minodori/spider_robot/modeling/sg90_arm.png

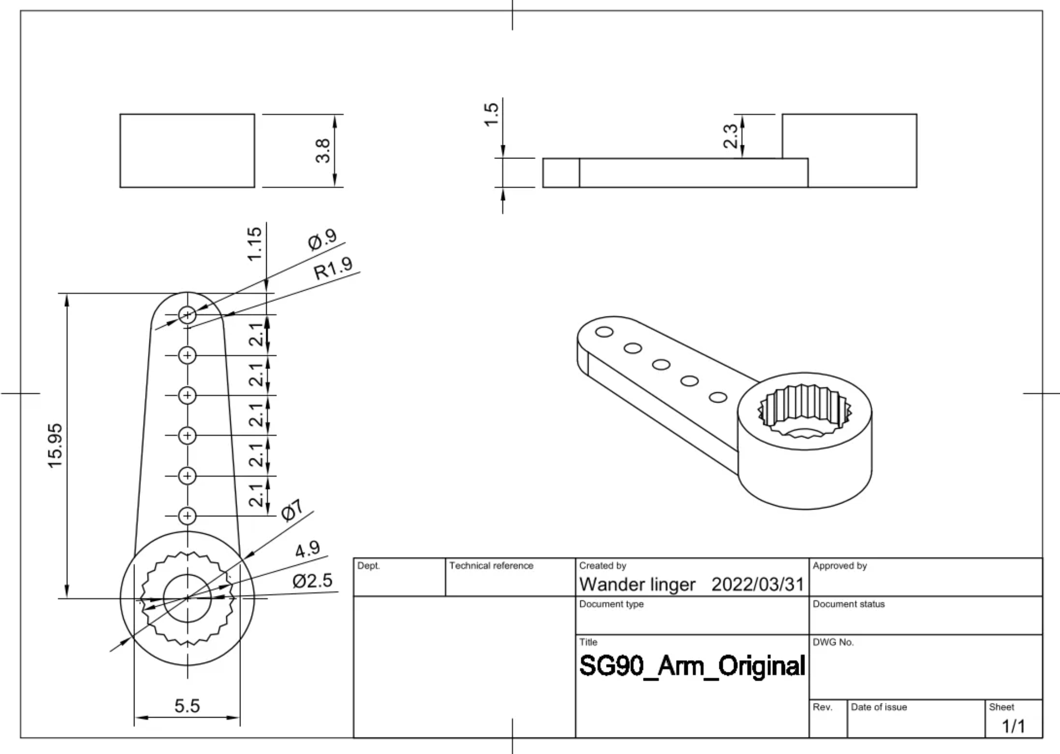
modeling/sg90_arm.png
