minodori/spider_robot/modeling/sg_90.png

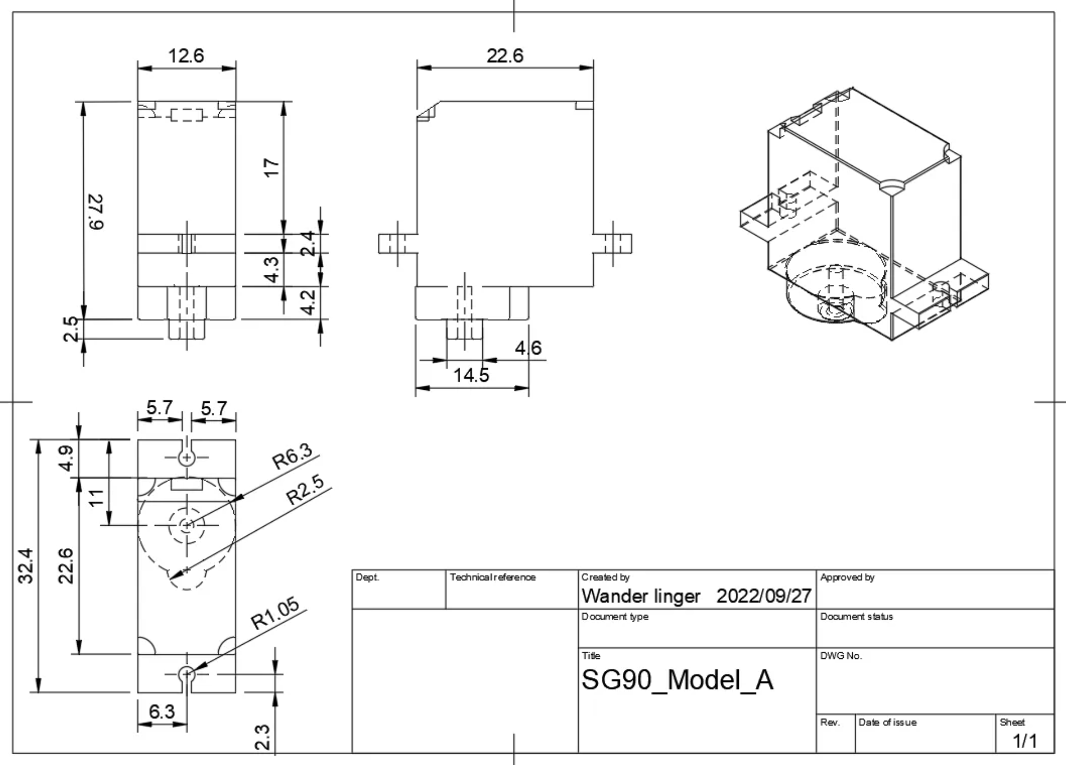
modeling/sg_90.png
