minodori/spider_robot/modeling/PlateTop_esp32_pcbway.3mf

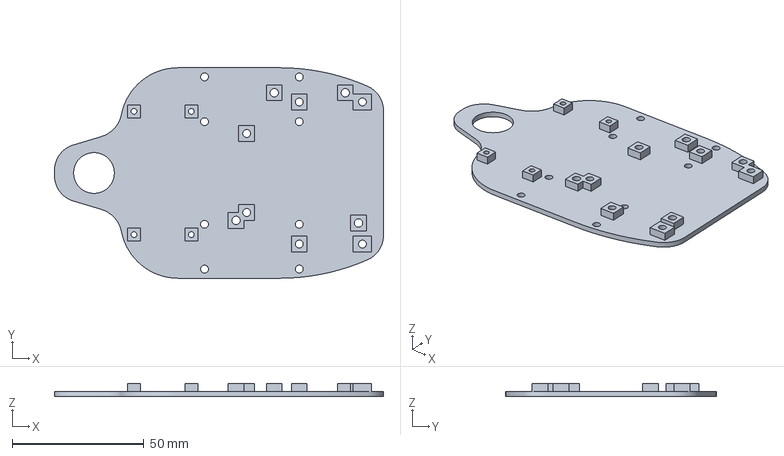
[picture p3: CAD file, 2026-04-04]
modeling/PlateTop_esp32_pcbway.3mf
125.0 x 80.0 x 5.00 mm
