minodori/spider_robot/modeling/PlateTop_esp32_pcbway_xl4015.3mf

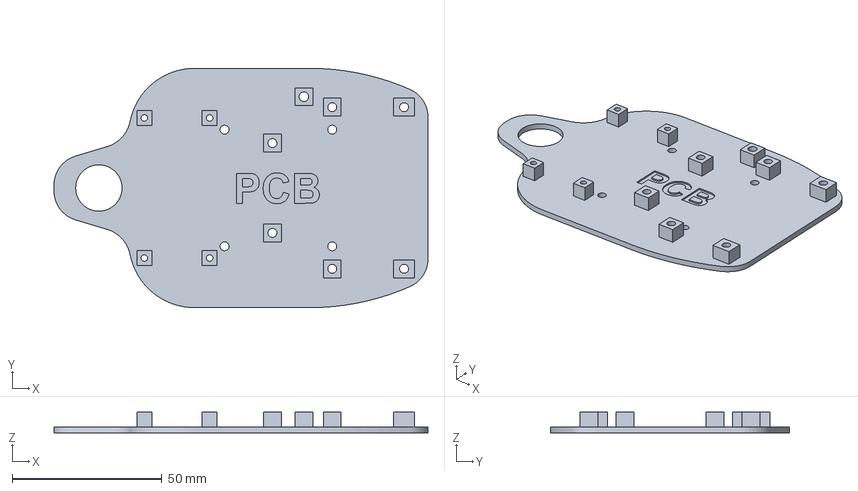
[picture p4: CAD file, 2026-04-04]
modeling/PlateTop_esp32_pcbway_xl4015.3mf
125.0 x 80.0 x 7.00 mm
