minodori/spider_robot/modeling/01-connector_37mm_5EA_Ender-5.3mf

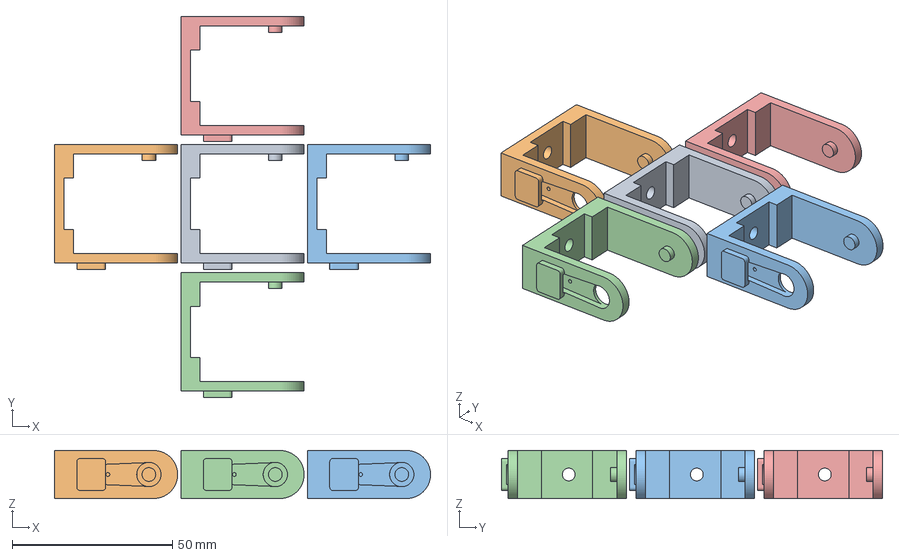
[picture p5: CAD file, 2026-04-04]
modeling/01-connector_37mm_5EA_Ender-5.3mf
117.5 x 119.0 x 15.0 mm
Connector_37mm.stl x 5
