minodori/spider_robot/modeling/PlateTop_pcbway_xl4015.step

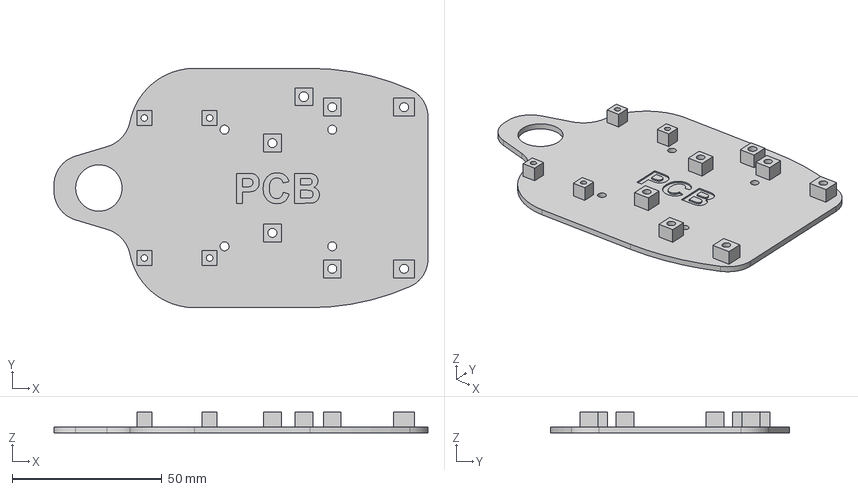
[picture p6: CAD file, 2026-04-04]
modeling/PlateTop_pcbway_xl4015.step
125.0 x 80.0 x 7.00 mm
