minodori/spider_robot/modeling/PlateTop_weedo_v20.stl

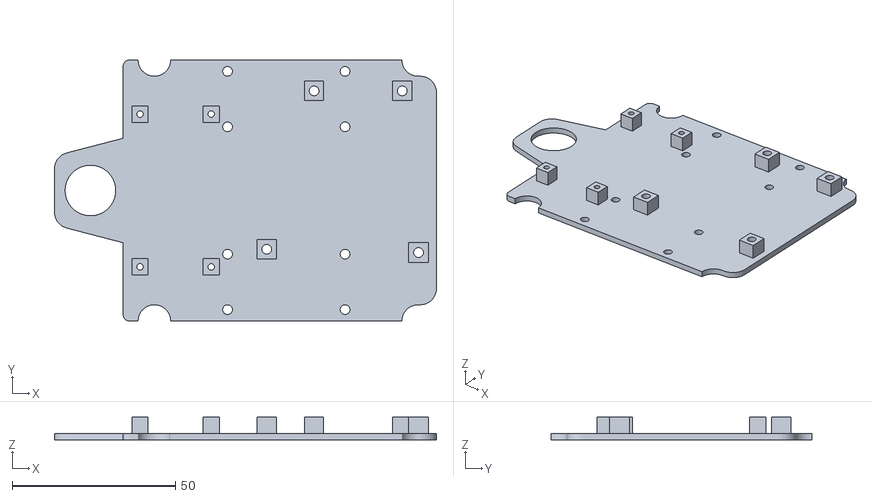
[picture p7: CAD file, 2026-03-12]
modeling/PlateTop_weedo_v20.stl
117.0 x 80.0 x 7.00
