minodori/spider_robot/modeling/01-platetop_PCBWay Community.3mf

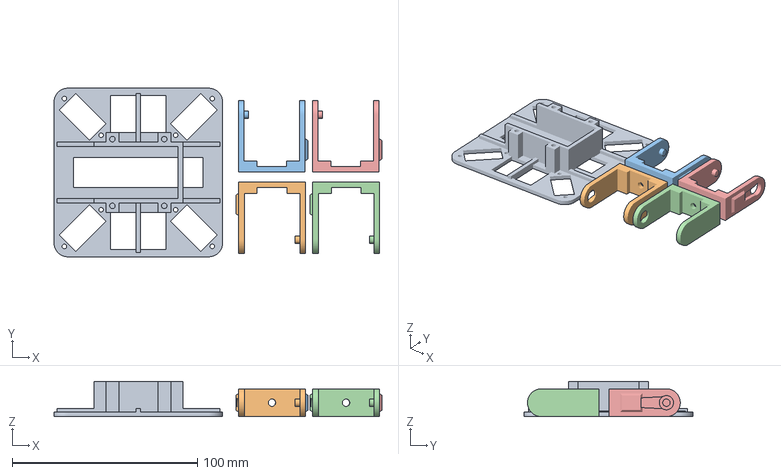
[picture p8: CAD file, 2026-03-12]
modeling/01-platetop_PCBWay Community.3mf
177.0 x 91.0 x 19.0 mm
01-plate_PCBWay Community.stl
01-connector_PCBWay Community.stl x 4
