minodori/spider_robot/modeling/4leg_plate_bottom.stl

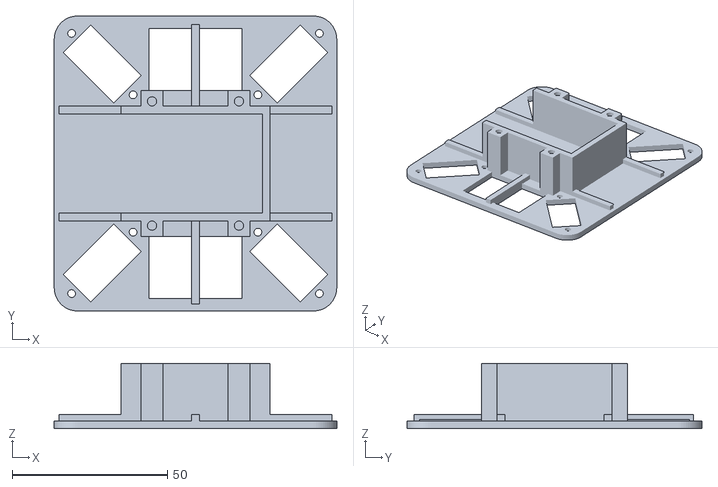
[picture p9: CAD file, 2026-03-12]
modeling/4leg_plate_bottom.stl
91.0 x 95.0 x 21.0
