minodori/spider_robot/modeling/Connector_37mm.stl

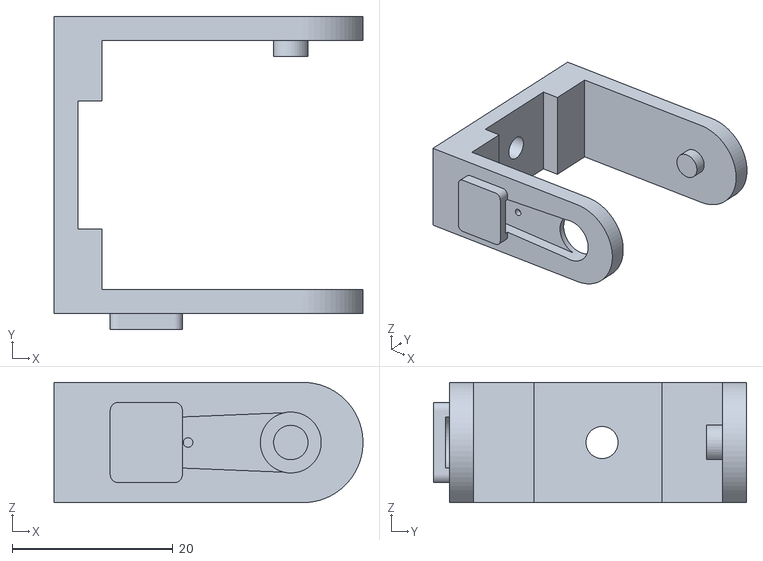
[picture p10: CAD file, 2026-03-12]
modeling/Connector_37mm.stl
38.5 x 39.0 x 15.0
