minodori/spider_robot/modeling/01-foot_PCBWay Community.stl

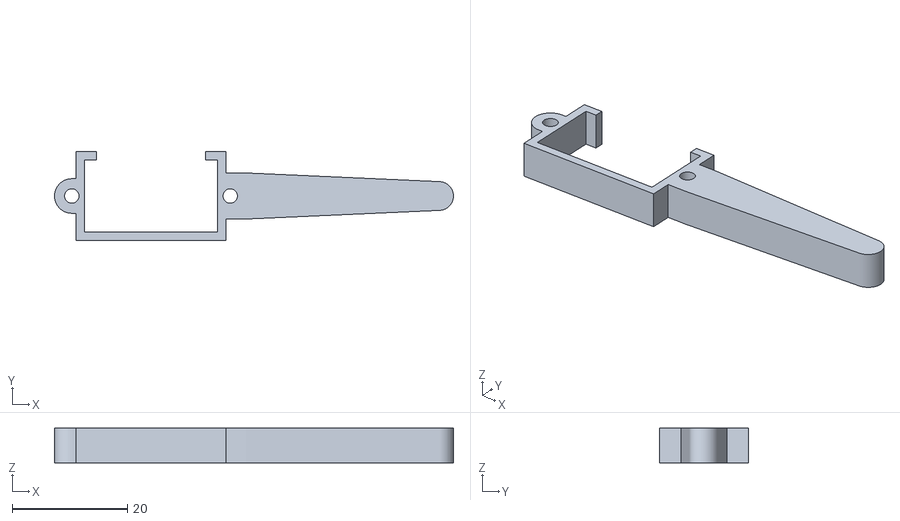
[picture p11: CAD file, 2026-03-12]
modeling/01-foot_PCBWay Community.stl
69.2 x 15.5 x 6.00
