minodori/spider_robot/modeling/Spider part.step

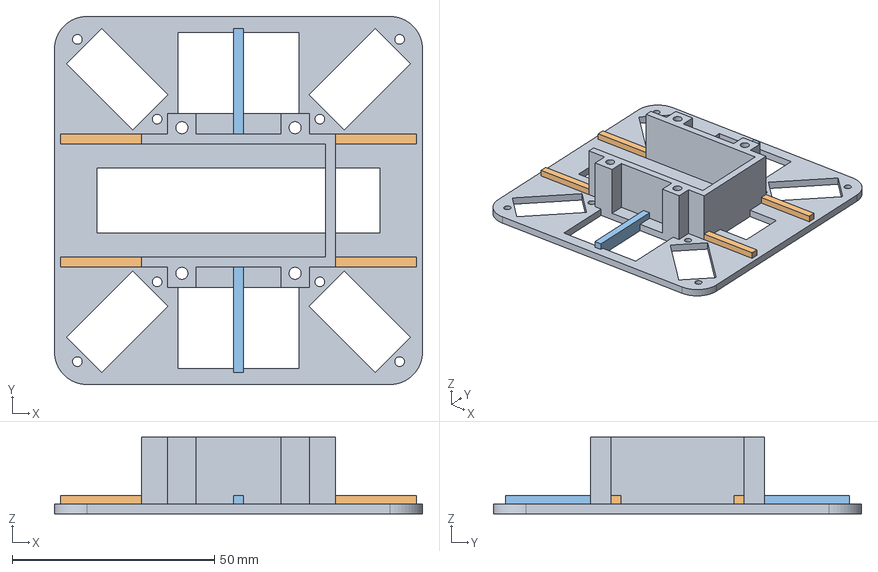
[picture p12: CAD file, 2026-03-12]
modeling/Spider part.step
91.0 x 91.0 x 19.0 mm
