minodori/spider_robot/modeling/01-connector_holder_PCBWay Community.3mf

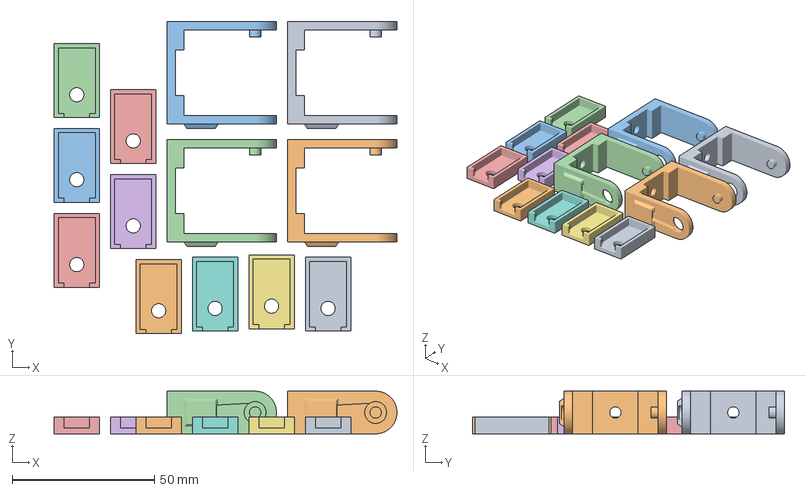
[picture p13: CAD file, 2026-03-12]
modeling/01-connector_holder_PCBWay Community.3mf
120.5 x 109.6 x 15.0 mm
01-connector_PCBWay Community.stl x 4
01-srv_holder_PCBWay Community.stl x 9
