minodori/spider_robot/modeling/Spider_31x54x16.3mf

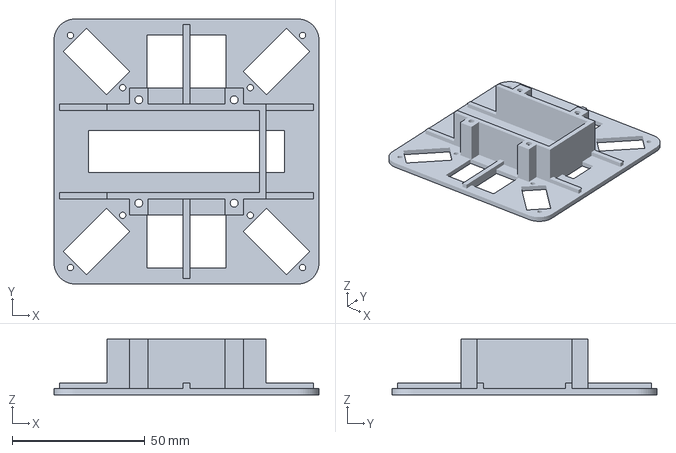
[picture p14: CAD file, 2026-03-12]
modeling/Spider_31x54x16.3mf
100.0 x 100.0 x 21.0 mm
