minodori/spider_robot/modeling/Connector_38mm.stl

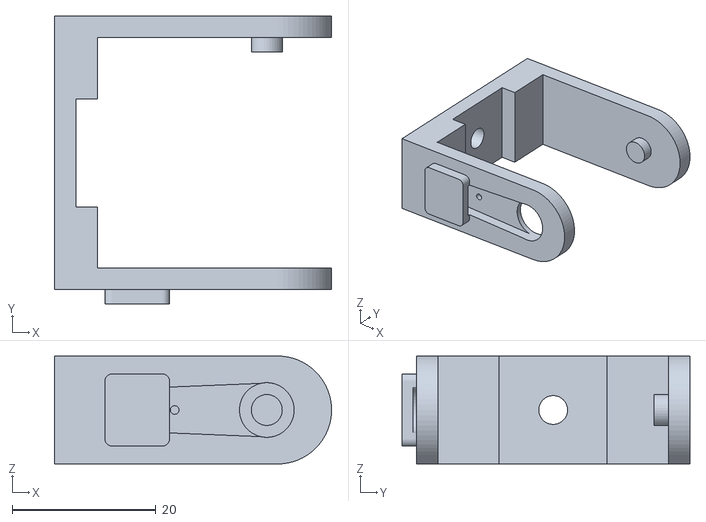
[picture p15: CAD file, 2026-03-12]
modeling/Connector_38mm.stl
38.5 x 40.0 x 15.0
