minodori/spider_robot/modeling/Connector_v10.step

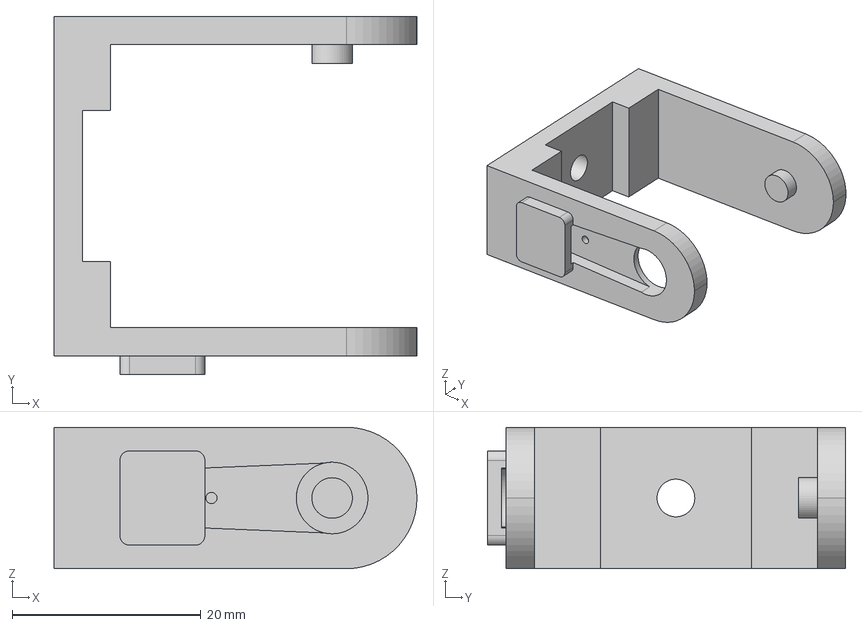
[picture p16: CAD file, 2026-03-12]
modeling/Connector_v10.step
38.5 x 38.0 x 15.0 mm
