minodori/spider_robot/modeling/01-plate_PCBWay Community.3mf

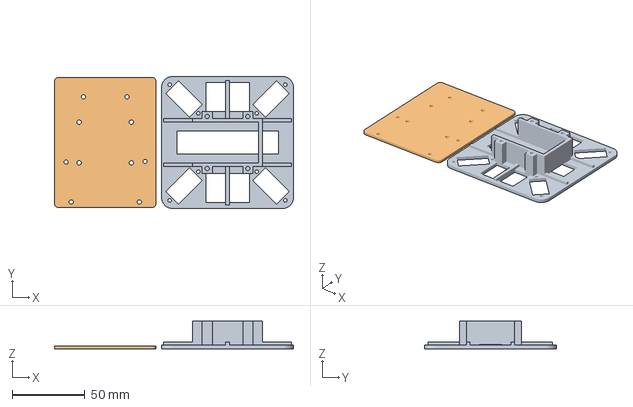
[picture p17: CAD file, 2026-03-12]
modeling/01-plate_PCBWay Community.3mf
164.8 x 91.0 x 19.0 mm
01-plate_PCBWay Community.stl
01-plate-top_PCBWay Community.stl
