minodori/spider_robot/modeling/Connector.3mf

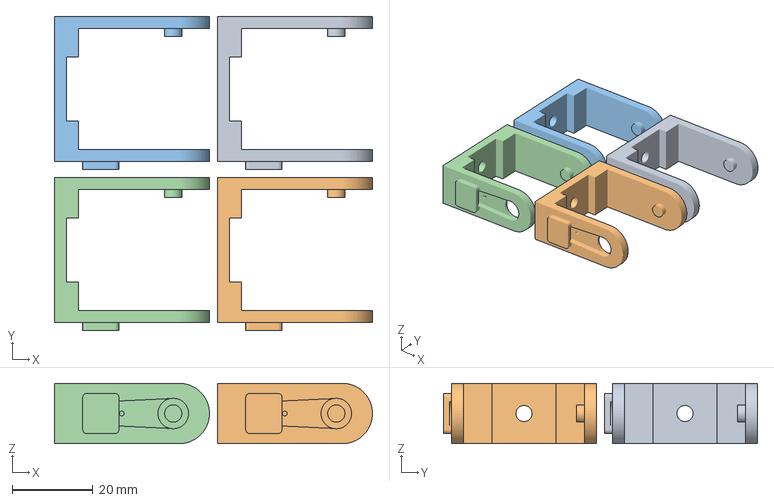
[picture p18: CAD file, 2026-03-12]
modeling/Connector.3mf
79.0 x 78.0 x 15.0 mm
Connector_v10.stl x 4
