minodori/spider_robot/modeling/PlateTop.3mf

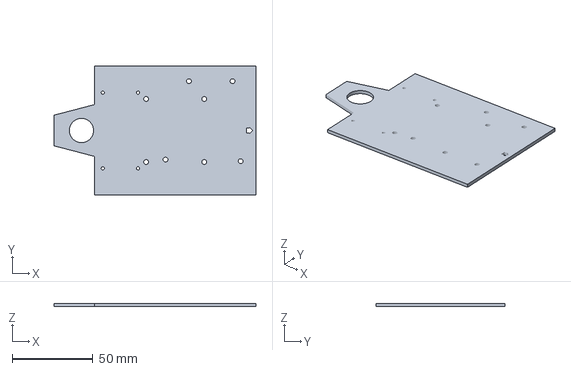
[picture p19: CAD file, 2026-03-12]
modeling/PlateTop.3mf
125.0 x 80.0 x 2.00 mm
