minodori/spider_robot/modeling/Plate_v20.3mf

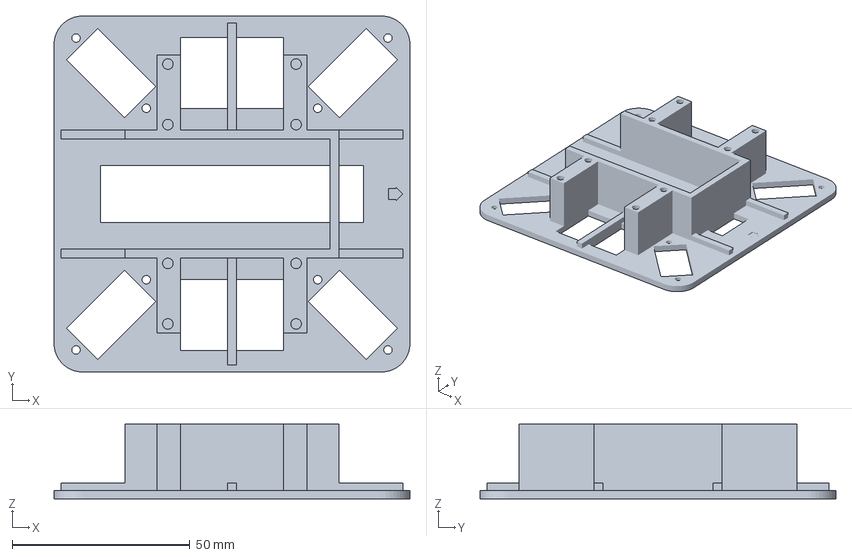
[picture p20: CAD file, 2026-03-12]
modeling/Plate_v20.3mf
100.0 x 100.0 x 21.0 mm
