minodori/spider_robot/modeling/01-srv_holder_PCBWay Community.3mf

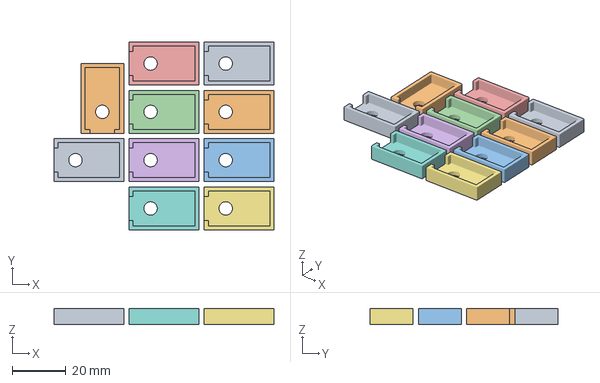
[picture p21: CAD file, 2026-03-12]
modeling/01-srv_holder_PCBWay Community.3mf
82.0 x 70.0 x 6.00 mm
01-srv_holder_PCBWay Community.stl x 10
