minodori/spider_robot/modeling/WT_Connector_v10.3mf

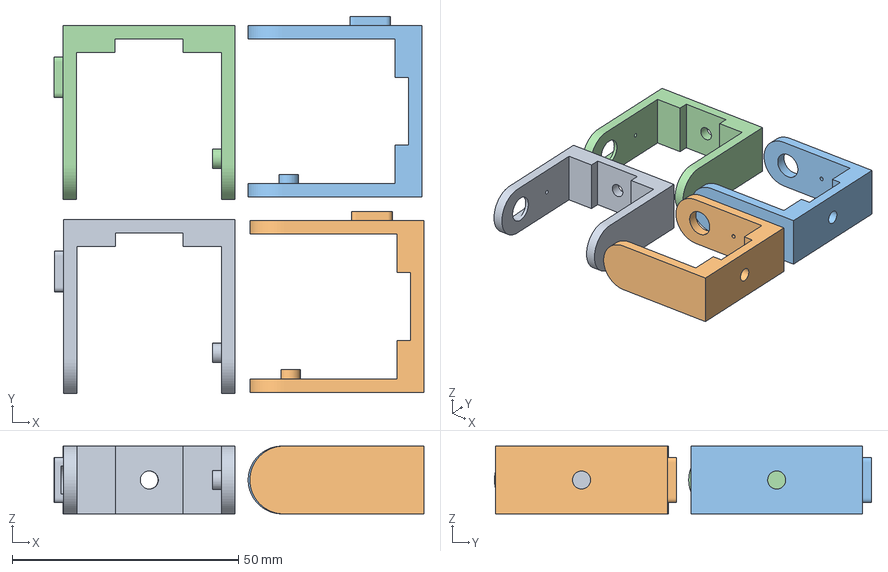
[picture p22: CAD file, 2026-03-12]
modeling/WT_Connector_v10.3mf
81.8 x 83.4 x 15.0 mm
Connector_38mm.stl
Connector_38mm.stl(1)
Connector_38mm.stl(2)
Connector_38mm.stl(3)
