minodori/spider_robot/modeling/01-foot_only.3mf

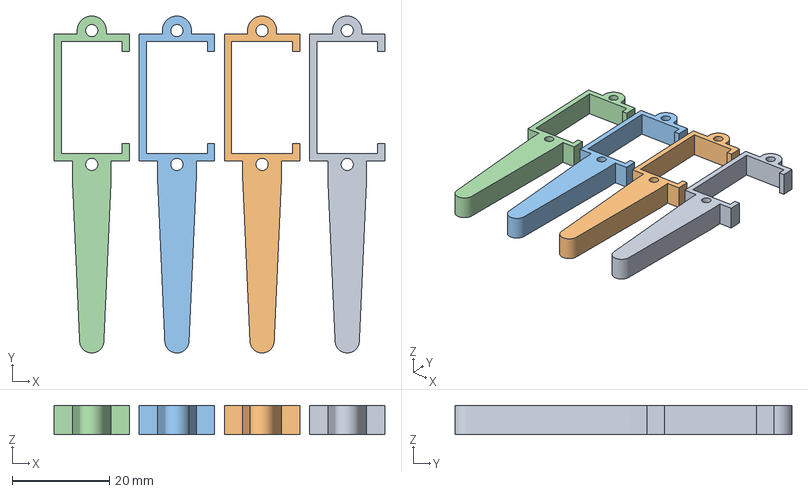
[picture p23: CAD file, 2026-03-12]
modeling/01-foot_only.3mf
68.0 x 69.3 x 6.00 mm
01-foot_PCBWay Community.stl x 4
