minodori/spider_robot/modeling/01-connector_foot_PCBWay Community.3mf

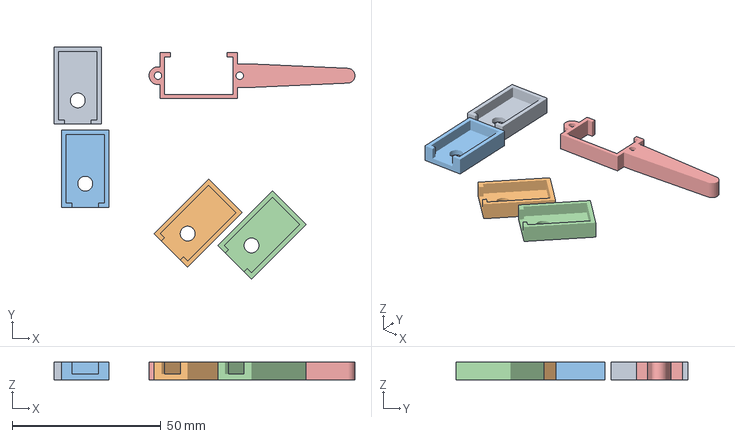
[picture p24: CAD file, 2026-03-12]
modeling/01-connector_foot_PCBWay Community.3mf
101.2 x 78.1 x 6.00 mm
01-srv_holder_PCBWay Community.stl x 4
01-foot_PCBWay Community.stl
