minodori/spider_robot/(list of files, cad)

Other CAD files:
modeling/01-connector_PCBWay Community.3mf
modeling/WT_PlateTop_weedo_v20.3mf
modeling/WT_01-srv_holder_PCBWay Community.3mf
modeling/Plate_31x54x16_v20.stl
modeling/PlateTop_31x54x16_v20.3mf
modeling/01-connector_PCBWay Community.stl
modeling/01-plate-top_PCBWay Community.stl
modeling/01-plate_PCBWay Community.stl
modeling/01-srv_holder_PCBWay Community.stl
modeling/Connector.stl
modeling/Connector_37mm.f3d
modeling/Connector_v10.3mf
modeling/Connector_v10.f3d
modeling/Connector_v10.stl
modeling/PlateTop.stl
modeling/PlateTop_31x54x16_v20.stl
modeling/PlateTop_pcbway_xl4015.f3d
modeling/Plate_v20.stl
modeling/Spider_31x54x16.stl
modeling/Spider_plate.f3d
