minodori/spider_robot/(commit log)

2026-03-05 refactor: 변수명 직관화 및 중복 제거
    - Abw/Afw → armFront/armWide (팔 자세 명확화)
    - initArm[], initFoot 제거 → footStand, armCenter 도입
    - WALK 몸밀기: 교차방식 → 4팔 동시 wide→front
    - reverseArm B,D: true→false (혼 모두 위쪽 조립 반영)
    [main.cpp]
2026-03-06 refactor: PCBWay 스타일로 동작 로직 전면 재구성
    - 변수명 PCBWay 기준으로 통일 (Fdw=40/Fup=60, Afw=45/Abw=135)
    - flat_up/flat_dw 함수 의미 재정의 (발 서보 방향 기반)
    - Afw/Abw 네이밍 물리적 의미에 맞게 교정 (값 교환 + 루프 방향 수정)
    - PCBWay 스타일 헬퍼 함수 추가: go_ahead, Xfoup/Xfodw, armXfw/bw
    - armTo(idx, target): 현재 위치 기준 목표 각도 이동 함수 추가
    - WALK: armTo 기반 단계별 동작으로 실험 중 (go_ahead 방향 문제 확인 중)
    - PCBWay 레퍼런스 파일 test/ 디렉토리에 추가
    [Spider_ESP32_BLE_Code_PCBWay Community.ino, Spider_Servo_Initial_Positions_PCBWay Community.cpp, main.cpp, servo_test.cpp]
2026-03-09 feat: 연속 반복 보행, 시리얼 개선, WALK 재구현
    - 동작 연속 반복: loop_running 플래그 + startLoopAction/startOnceAction/stopAction
    - 시리얼: 문자 단위 루프로 변경, 스페이스바 즉시 정지, stop 명령 추가
    - stall(): 현재 위치에서 초기자세로 spd 속도로 점진 이동
    - up/dn 1회 실행 분리, updn 교대 연속 반복 추가 (웹 버튼 포함)
    - WALK 재구현: 정적 크리프 보행 (A→D→B→C 대각선 순서)
    A,C: 전방=45°→뒤로 당김=135° / B,D: 전방=135°→뒤로 당김=45°
    [main.cpp]
2026-03-11 refactor: 보행 파라미터를 물리각 테이블로 재구성
    - reverseArm/armOffset/Afw/Abw/Astl 제거
    - phyContact[]+armDir[]+stride 구조로 교체
    - toeoff = contact + armDir * stride 자동 계산
    - write함수 변환 로직 제거, 물리각 직접 기록
    - 좌우/전후 대칭 문제 해결
    [main.cpp]
2026-03-12 docs: define Crawl V1.0 gait, add simulation and modeling assets
    - docs/DESIGN.md: WALK 동작을 Crawl V1.0으로 정의, 보행 파라미터 표 및 사이클 문서화
    - simulation/walk_sim.py: PyBullet 기반 Crawl V1.0 보행 시각화
    - modeling/: 3D 모델 파일 추가 (STL, 3MF, F3D, STEP)
    - .gitignore: modeling/*.gcode 제외
    [01-connector_PCBWay Community.stl, 01-connector_foot_PCBWay Community.3mf, 01-connector_holder_PCBWay Community.3mf, 01-foot_PCBWay Community.stl, 01-foot_only.3mf, 01-plate-top_PCBWay Community.stl, 01-plate_PCBWay Community.3mf, 01-plate_PCBWay Community.stl]
2026-03-29 feat: trot 보행 시뮬레이션 추가 및 crawl 물리 시뮬레이션 재설계
    - simulation/trot_sim.py: trot.csv 기반 3/4-delay 4박자 보행 구현
    - 24 step 사이클, 각 다리 phase offset (FL=15, FR=4, BL=10, BR=23)
    - 물리 시뮬레이션: 몸체 비고정, 실제 이동
    - URDF에 collision geometry 추가로 바닥 통과 버그 수정
    - simulation/walk_sim.py: crawl 물리 시뮬레이션 안정화
    - 순차 단독 push → 4다리 동시 state machine으로 재설계
    (스윙 1개 + 스탠스 3개 동시 push → 몸체 회전 방지)
    - 바닥 마찰 1.5 → 3.0, 몸체 angularDamping=0.9 추가
    - URDF collision geometry 추가
    - docs/DESIGN.md: Trot 보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
    [trot.csv]
2026-03-30 refactor: URDF를 spider_urdf.py로 분리하여 walk/trot_sim이 공유
2026-03-30 refactor: URDF를 spider.urdf XML 파일로 분리, tempfile 방식 제거
    [spider.urdf]
2026-03-30 fix: spider.urdf 다리 배치 변경에 따른 gait 파라미터 재매핑
    - spider.urdf: 다리 배치 변경 (A=FR, B=BR, C=FL, D=BL)
    - foot 링크에 inertial, collision 추가 (loadURDF 오류 수정)
    - foot 조인트에 limit 추가 (REVOLUTE limit 경고 수정)
    - XML 태그 오류 수정
    - walk_sim.py / trot_sim.py: PHY_CONTACT, ARM_DIR, SWING_START 재매핑
    [spider.urdf]
2026-03-30 fix: 잘못 재매핑한 gait 파라미터 원복 (A=FL, B=FR, C=BL, D=BR)
    직전 커밋에서 URDF xyz 좌표 수정을 다리 순서 변경으로 오해하여
    PHY_CONTACT/ARM_DIR/SWING_START를 잘못 재매핑한 것을 되돌림.
    URDF 수정 내용: 좌표계 오류 수정이었고 A~D 매핑은 기존과 동일.
2026-03-30 refactor: gait 각도 기준을 URDF 세계좌표(오른손계)로 변경
    - PHY_CONTACT: 구 servo 기준(100,80,30,150) → world-frame deg(55,-55,125,-125)
    - PHY_STL → MOUNT_YAW (각 다리 장착 방향: 45,-45,135,-135)
    - arm_sim(): phy_deg-PHY_STL → world_deg-MOUNT_YAW 로 변환 방식 변경
    - ARM_DIR: +1=CCW (세계좌표 반시계 = 전진 방향) 명확화
2026-04-04 현재 버전 정리. 각도 재정의 main 수정 전
    [01-connector_37mm_5EA_Ender-5.3mf, 01-connector_PCBWay Community.3mf, PlateTop_esp32_pcbway.3mf, PlateTop_esp32_pcbway_xl4015.3mf, PlateTop_pcbway_xl4015.f3d, PlateTop_pcbway_xl4015.step]
2026-04-10 feat: CoG pre-shift 재설계, 스텝모드, sim GUI 개선
    main.cpp
    - FOOT 논리각 좌표계 재정의: A,C 양수 / B,D 음수, toServoFoot() 분기 처리
    - cogShift(swingLeg): 지지 발 foot 이동으로 무게중심 조정
    - cogRestore(bool skip[]): swing 후 legFdw 복귀, 다음 cogShift 대상 제외
    - stall(bool smooth): smooth=false 즉시이동 / smooth=true 점진이동 분리
    - fodw(leg, tgt): 목표 논리각 파라미터 추가
    - spdDelay(): step_mode 지원 (스페이스 대기)
    - 시리얼 명령 추가: step(스텝모드 토글), cog 파싱 버그 수정
    - sts 출력: Arm/Foot(log) 논리각 표시, cogAlpha 추가
    simulation/walk_sim.py
    - GUI 스텝 버튼 추가 (슬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
    [main.cpp]
2026-06-21 refactor: main.cpp를 서보 모터 테스트 코드로 교체
    WiFi/웹서버 기반 전체 제어 코드에서 시리얼 명령 기반 서보 테스트 코드로 변경.
    채널별(a~d) arm/foot 개별 제어 및 각도 지정 명령 지원.
